DigitalREP-IL/DR-2-TXRX/DR-2_RX_glamour_shot.png

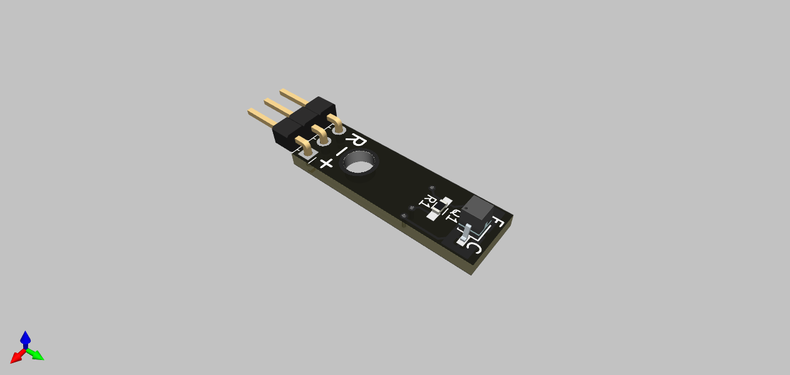
DR-2_RX_glamour_shot.png
