DigitalREP-IL/DR-2-TXRX/combined BOMS.xlsx

Model | Component | Desc | Manf | MPN | QTY | Price @ 100 | Component Ext
DR1 |  | PiRCy
 | R102 | Resistor, 56R | Vishay | CRCW060356R0FKEA | 1 | 0.013
 | R101 | Resistor, 560R | Vishay | CRCW0603560RFKEA | 1 | 0.015
 | C101 | Capactitor, 1uF, 10V MLCC | Vishay | VJ0603V105MXQPW1BC | 1 | 0.081
 | D101 | High Speed IR LED, wide angle | Vishay | VSMB2948 | 1 | 0.331
 | U101 | IR Receiver, 38kHz | Vishay | TSOP77438TT | 1 | 0.954
 | Q101 | N-FET, 3.3V rated | Vishay | Si2304DDS-T1-E3 | 1 | 0.188
 | J101 | Connector, 6+6 DIL | Harwin | M20-7920642R | 1 | 1.21 | $2.79
DR2-TX |  | Sender Board
 | Q1 | N-FET, 3.3V rated | Vishay | SI2312BDS-T1-E3 | 1 | 0.255
 | RPU | Resistor, 10K 0603 | Vishay | CRCW060310K0FKEAC | 1 | 0.028
 | RLIM | Resistor, 91R, 1/8W | Vishay | CRCW060391R0FKEA (https://www.mouser.com/ProductDetail/Vishay-Dale/CRCW060391R0FKEA/?qs=FlacDpl4iRFfY8SE%2FZlbHw%3D%3D) | 1 | 0.013
 | D1 | High Speed IR LED | Vishay | VSMB2020X01 | 1 | 0.36
DR2-RX |  | Receiver Board
 | Q1 | IR Phototransistor | Vishay | VEMT2023X01 | 1 | 0.395
 | R1 | Resistor, 6K2 | Vishay | CRCW06036K20FKEA | 1 | 0.013 | $1.06
DR3-1 |  | Reflective, TCRT Option
 | Q1 | N-FET, 3.3V rated | Vishay | SI2312BDS-T1-E3 | 1 | 0.255
 | RPU | Resistor, 10K 0603 | Vishay | CRCW060310K0FKEAC | 1 | 0.028
 | RE | Resistor, 91R, 1/8W | Vishay | CRCW060391R0FKEA (https://www.mouser.com/ProductDetail/Vishay-Dale/CRCW060391R0FKEA/?qs=FlacDpl4iRFfY8SE%2FZlbHw%3D%3D) | 1 | 0.013
 | RPD | Resistor, 6K2 | Vishay | CRCW06036K20FKEA | 1 | 0.013
 | U1 | Reflective optical sensor, TH | Vishay | TCRT5000 | 1 | 0.624 | $0.93
DR3-2 |  | Reflective, VCNT Option
 | Q1 | N-FET, 3.3V rated | Vishay | SI2312BDS-T1-E3 | 1 | 0.255
 | RPU | Resistor, 10K 0603 | Vishay | CRCW060310K0FKEAC | 1 | 0.028
 | RE | Resistor, 91R, 1/8W | Vishay | CRCW060391R0FKEA (https://www.mouser.com/ProductDetail/Vishay-Dale/CRCW060391R0FKEA/?qs=FlacDpl4iRFfY8SE%2FZlbHw%3D%3D) | 1 | 0.013
 | RPD | Resistor, 6K2 | Vishay | CRCW06036K20FKEA | 1 | 0.013
 | U2 | Reflective optical sensor, SM | Vishay | VCNT2020 | 1 | 0.389 | $0.70
