DigitalREP-IL/DR-2-TXRX/test_.FCStd

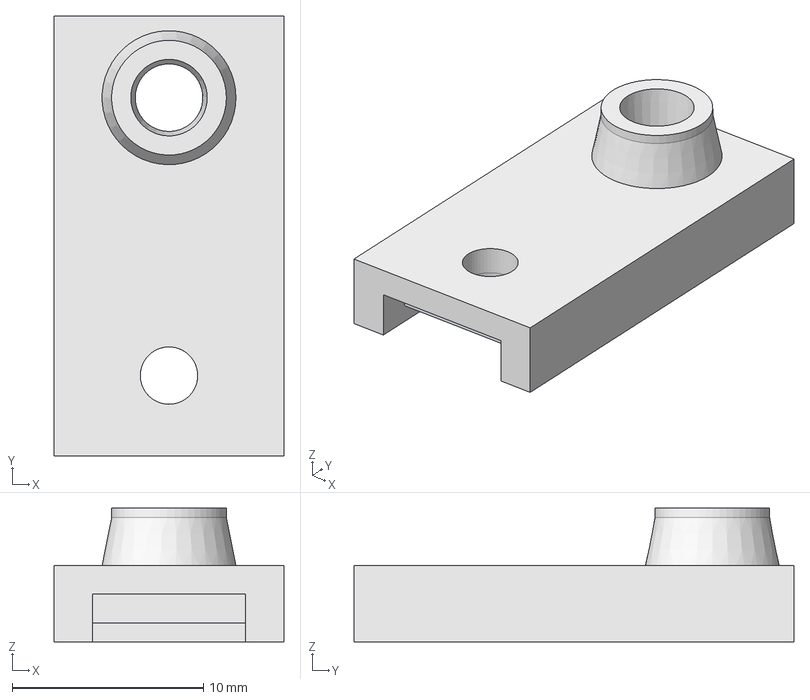
[picture p5: CAD file, 2024-03-14]
test_.FCStd
12.0 x 23.0 x 7.00 mm
