DigitalREP-IL/DR-2-TXRX/(list of files, cad)

Other CAD files:
test_bracket.stl
