DigitalREP-IL/DR-2-TXRX/DR-2_RX.pdf

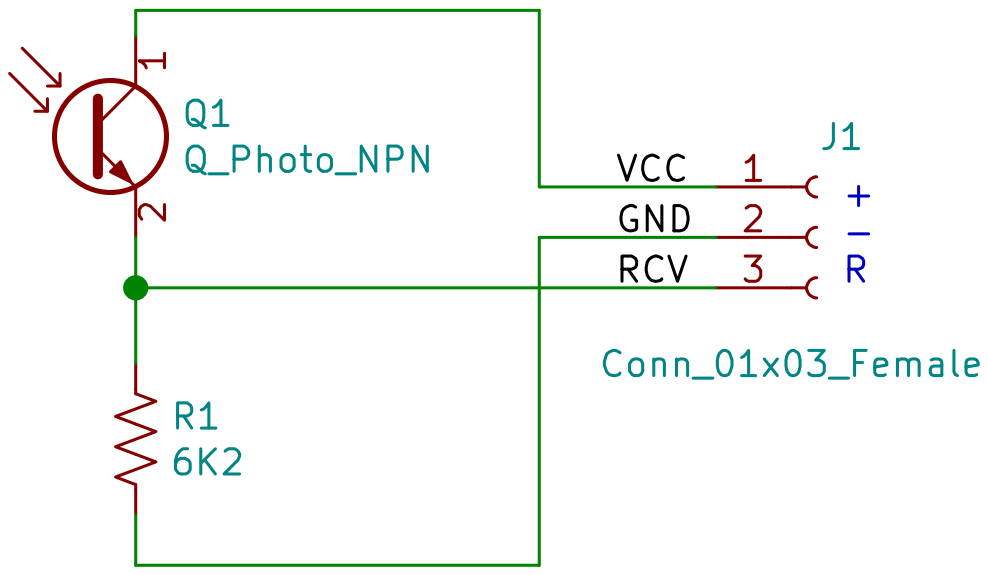
[picture p6: page 1]

File: DR-2_RX.sch Sheet: / Digital-REP Receive Side

Id: 1/1 Title: Break-Beam sensor set
