DigitalREP-IL/DR-2-TXRX/DR-2_TX.pdf

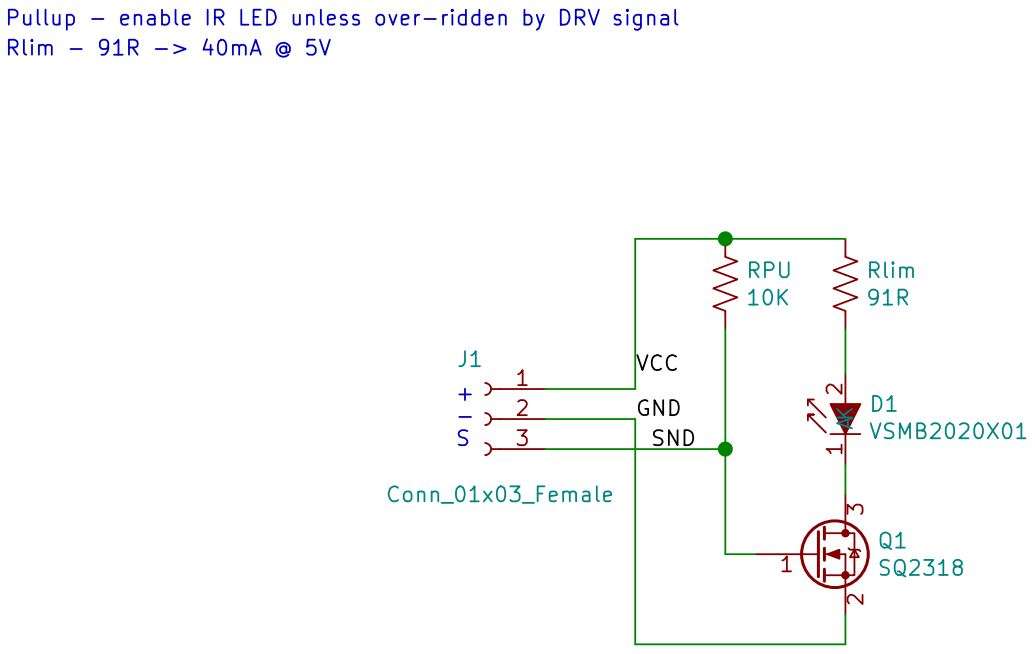
[picture p7: page 1]

Pullup - enable IR LED unless over-ridden by DRV signal +
-S Rlim - 91R -> 40mA @ 5V

Transmit Side
File: DR-2_TX.sch Sheet: / Digital-REP

Id: 1/1 Title: Break-Beam sensor set
