DigitalREP-IL/DR-2-TXRX/DR-2_TX.kicad_pcb

## KiCad design DR-2_TX.kicad_pcb (2024-03-14)

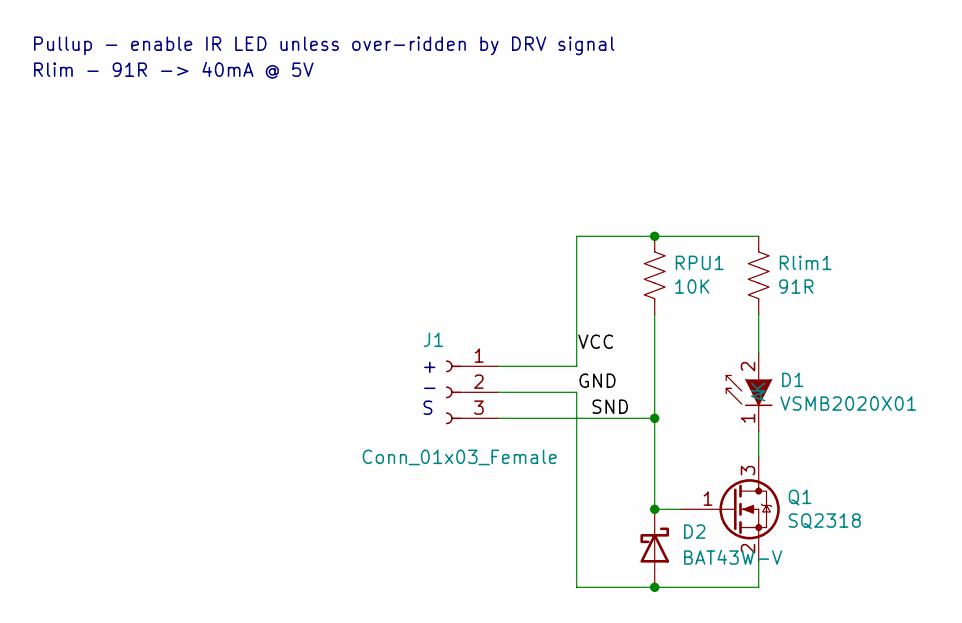
[picture p8: schematic DR-2_TX.kicad_sch, Break-Beam sensor set]

Parts:
D1: VSMB2020X01; VSMG28011G
D2: BAT43W-V; D_SOD-123
J1: Conn_01x03_Female; Pin_Header_Angled_1x03_Pitch2.54mm
Q1: SQ2318; SOT-23
RPU1: 10K; R_0603_HandSoldering
Rlim1: 91R; R_0603_HandSoldering

Connections:
/GND: D2.2 (A), J1.2, Q1.2 (S)
/SND: D2.1 (K), J1.3, Q1.1 (G), RPU1.2
/VCC: J1.1, RPU1.1, Rlim1.1
unnamed: D1.1 (K), Q1.3 (D)
unnamed: D1.2 (A), Rlim1.2

Notes on the sheet:
Rlim - 91R -> 40mA @ 5V
Pullup - enable IR LED unless over-ridden by DRV signal
+ - S

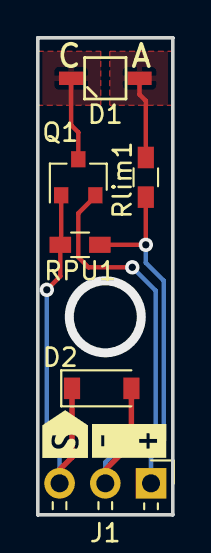
[picture p9: board DR-2_TX.kicad_pcb from above]

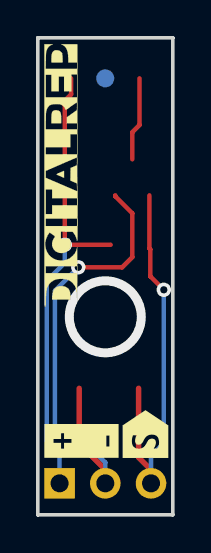
[picture p10: board DR-2_TX.kicad_pcb from below]

Board: 2 copper layers, 7.5 x 26.5 mm, 10 parts (2 on the bottom side), 5 nets.

Other parts of the board:
kibuzzard-6377ADC5: G***; kibuzzard-6377ADC5
kibuzzard-6377ADF0: G***; kibuzzard-6377ADF0
kibuzzard-6377B0BC: G***; kibuzzard-6377B0BC
kibuzzard-6377B096: G***; kibuzzard-6377B096
