DigitalREP-IL/DR-2-TXRX/DR-2_RX.kicad_pcb

## KiCad design DR-2_RX.kicad_pcb (2024-03-14)

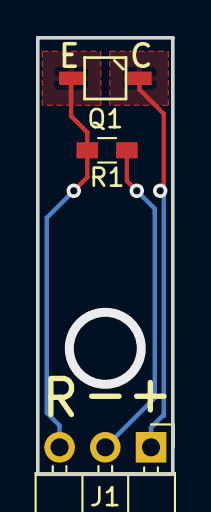
[picture p11: board DR-2_RX.kicad_pcb from above]

Board: 2 copper layers, 7.5 x 24.2 mm, 3 parts (0 on the bottom side), 3 nets.

Parts:
J1: Conn_01x03_Female; Pin_Header_Angled_1x03_Pitch2.54mm
Q1: Q_Photo_NPN; VSMG28011G
R1: 10K; R_0603_HandSoldering

Connections:
/GND: J1.2, R1.2
/SIG: J1.3, Q1.2, R1.1
/VCC: J1.1, Q1.1
